d1rty-pixel/CR10-Standalone-Mod/README.md

# Creality CR10 - Standalone Mod

This mod adds a Voron-styled electronics compartment underneath the printer to replace the factory control box. It will also add stability and rigidity and weight to the frame. It also improves cooling and provides better maintenance access to your electronics.
