d1rty-pixel/CR10-Standalone-Mod/STL/plate_mains.stl

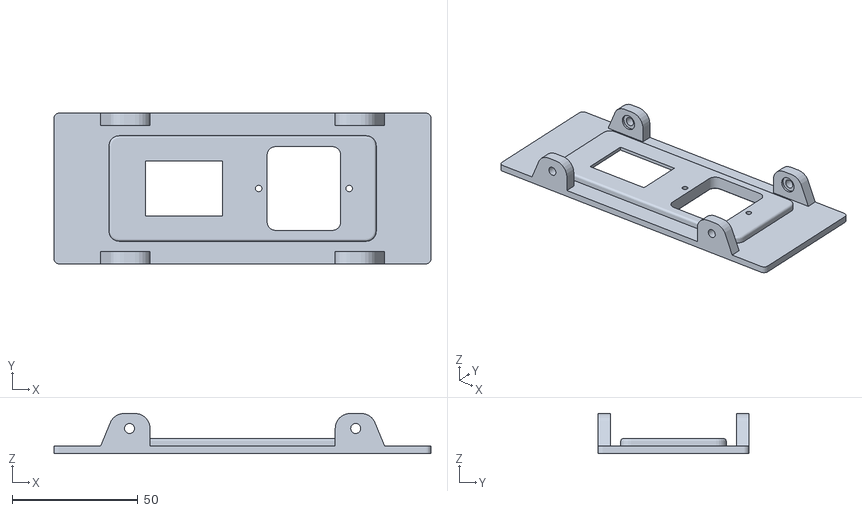
[picture p7: CAD file, 2022-02-13]
STL/plate_mains.stl
150.0 x 60.0 x 16.0
