d1rty-pixel/CR10-Standalone-Mod/STL/plate_normal_x4.stl

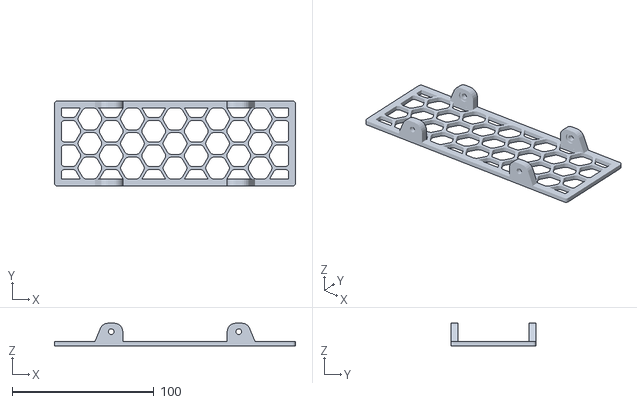
[picture p8: CAD file, 2022-02-13]
STL/plate_normal_x4.stl
170.0 x 60.0 x 16.0
