d1rty-pixel/CR10-Standalone-Mod/STL/plate_fan_x2.stl

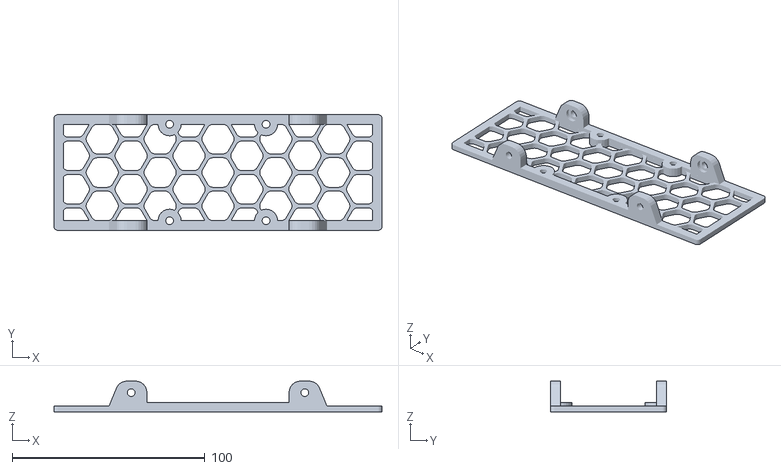
[picture p9: CAD file, 2022-02-13]
STL/plate_fan_x2.stl
170.0 x 60.0 x 16.0
