d1rty-pixel/CR10-Standalone-Mod/STL/plate_passthrough.stl

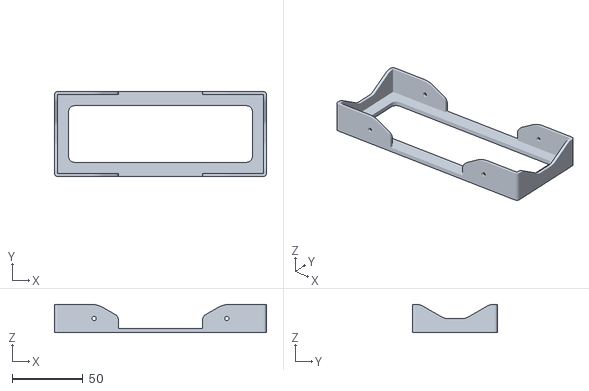
[picture p10: CAD file, 2022-01-30]
STL/plate_passthrough.stl
150.0 x 60.0 x 20.0
