d1rty-pixel/CR10-Standalone-Mod/(commit log)

2022-01-30 initial import of STL files
    [plate_fan_x2.stl, plate_mains.stl, plate_normal_x4.stl, plate_passthrough.stl]
2022-01-30 fixes orientation
    [plate_fan_x2.stl, plate_mains.stl, plate_normal_x4.stl, plate_passthrough.stl]
2022-01-30 updates documentation on STL files
2022-02-03 updates mount brackets for easier installation
    [plate_fan_x2.stl, plate_normal_x4.stl]
2022-02-13 fixes mount points
    [plate_fan_x2.stl, plate_mains.stl, plate_normal_x4.stl]
